4ilo/Wireless-Jukebox/Wireless Jukebox pcb/pcbV1.png

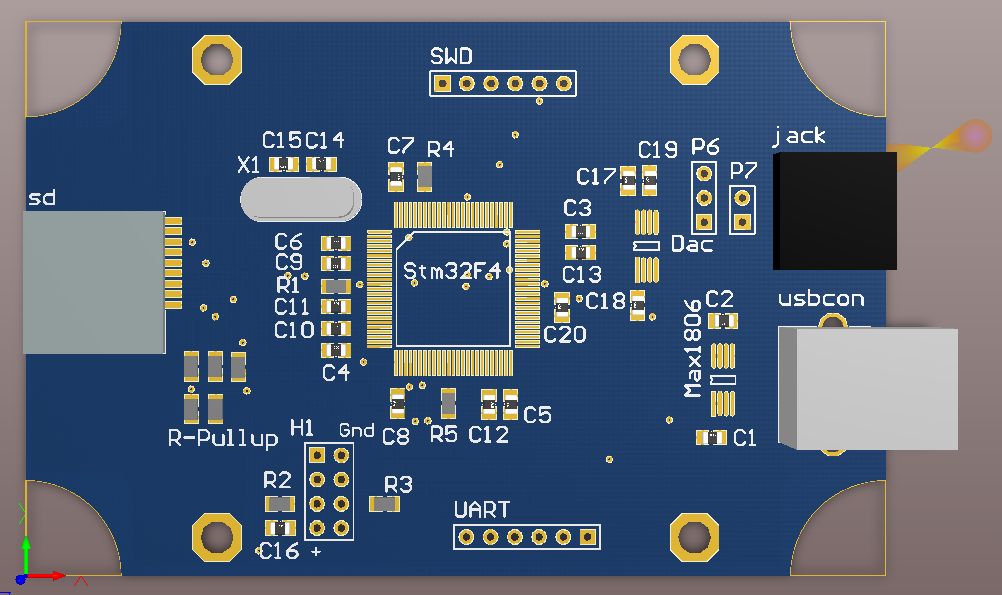
Wireless Jukebox pcb/pcbV1.png
