4ilo/Wireless-Jukebox/readme.md

# Wireless Jukebox

Ontwikkelen van een embedded systeem op basis van een cortex M4(stm42F411) dat muziek van een sd-kaart leest en deze afspeeld. De module wordt verbonden met een esp8266 wifi module waarop een webserver zal draaien. 
Gebruikers kunnen nu inloggen via wifi op de esp8266 en stemmen voor het volgende liedje. Als uitbreiding is het eventueel nog mogelijk om een wachtrij van liedjes te maken.
