4ilo/Wireless-Jukebox/Eindverslag/pdf/Bijlage 5.pdf

### Bijlage 5:

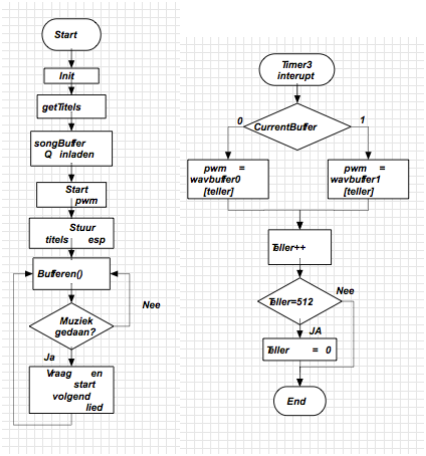
[picture p11: figure]

Fig1: Flowchart main

Fig2: Flowchart interrupt

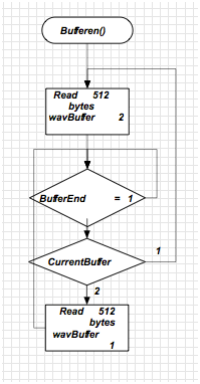
[picture p12: figure]

Fig3: Flowchart bufferen muziek
