4ilo/Wireless-Jukebox/Eindverslag/Bijlage/flowchart.pdf

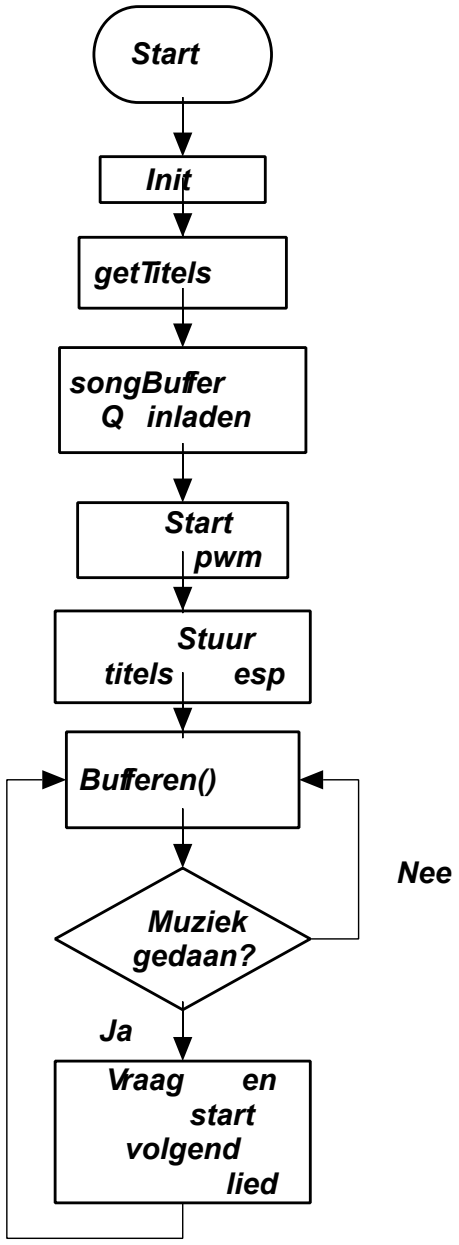
[picture p14: figure]
Start; Init; getTitels; songBuffer Q inladen; Start pwm; Stuur; titels; esp; Bufferen(); Muziek gedaan?; Vraag; start volgend lied; Nee
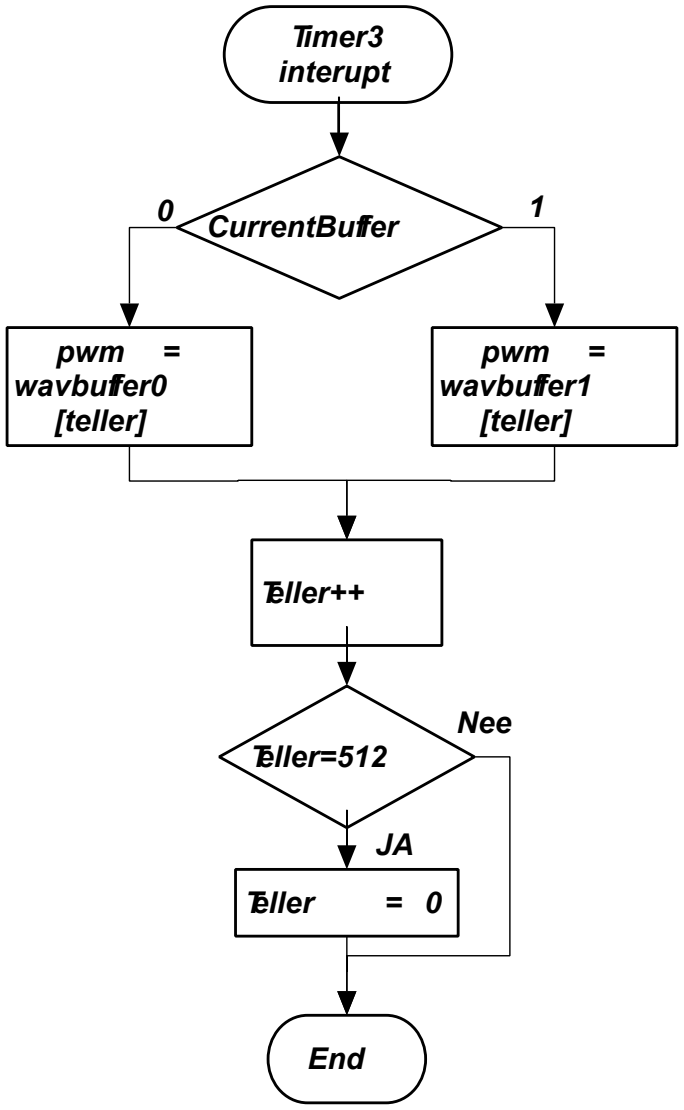
[picture p15: figure]
Timer3 interupt; CurrentBuffer; pwm = wavbuffer0 [teller]; pwm = wavbuffer1 [teller]; Teller++; Teller=512; Teller; End; Nee
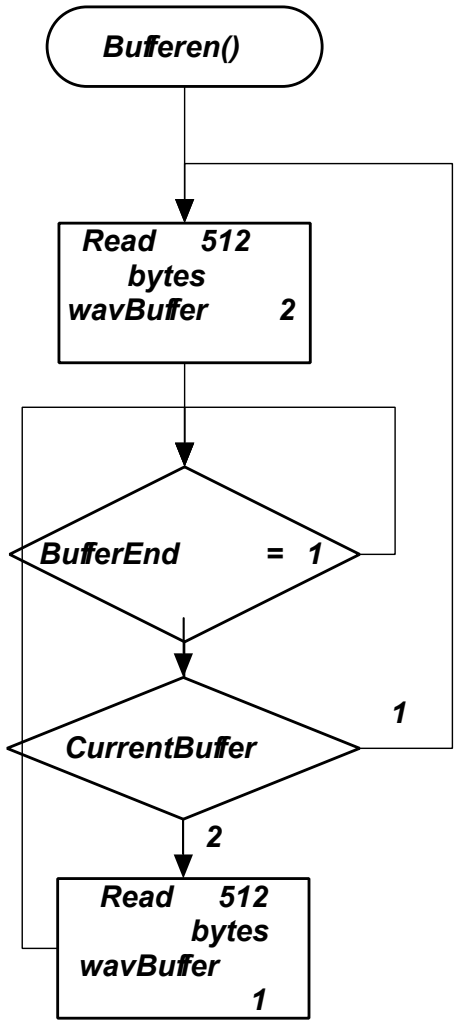
[picture p16: figure]
Bufferen(); Read; bytes wavBuffer; BufferEnd; CurrentBuffer
