4ilo/Wireless-Jukebox/Eindverslag/pdf/voorwoord.pdf

### Voorwoord

Ik ben Olivier Van den Eede.
olivier.vandeneede@student.thomasmore.be
Voor mijn opleiding Electronica-Ict in de 2de fase aan Thomas More De Nayer heb ik een project gemaakt, namelijk de Wireless-Jukebox.
De reden voor het maken van dit project is omdat ik graag wilde werken met een 32bit microcontroller, een SD-kaart en een wifi-module. Dit project beantwoord aan al deze criteria.

2
