4ilo/Wireless-Jukebox/cubeMX layout/LayoutV1.png

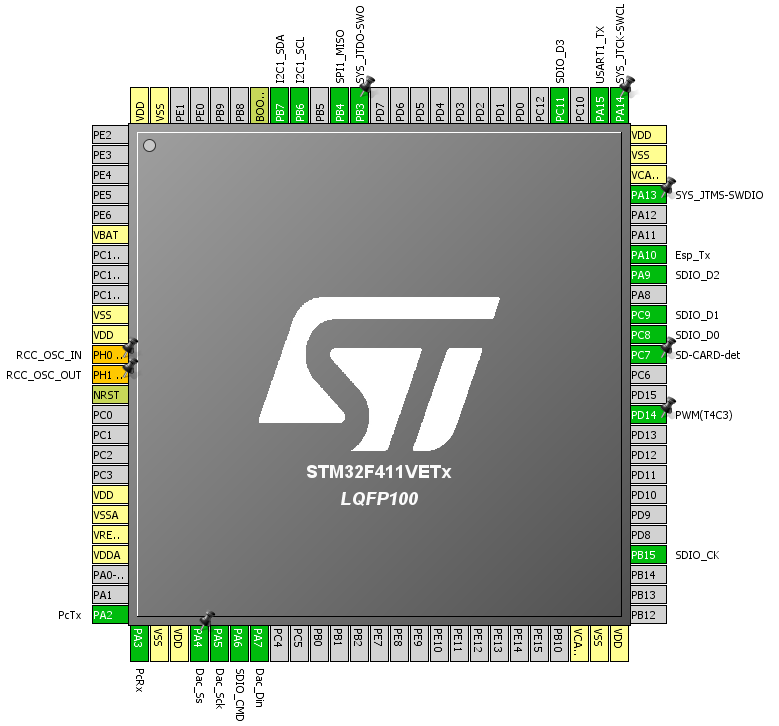
cubeMX layout/LayoutV1.png
