4ilo/Wireless-Jukebox/Eindverslag/foto's/blokschema.png

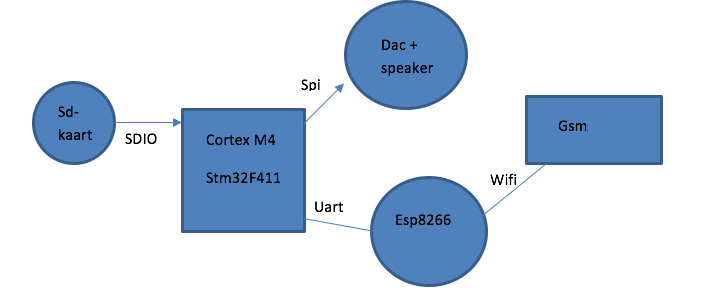
Eindverslag/foto's/blokschema.png
