4ilo/Wireless-Jukebox/Eindverslag/foto's/pcb.png

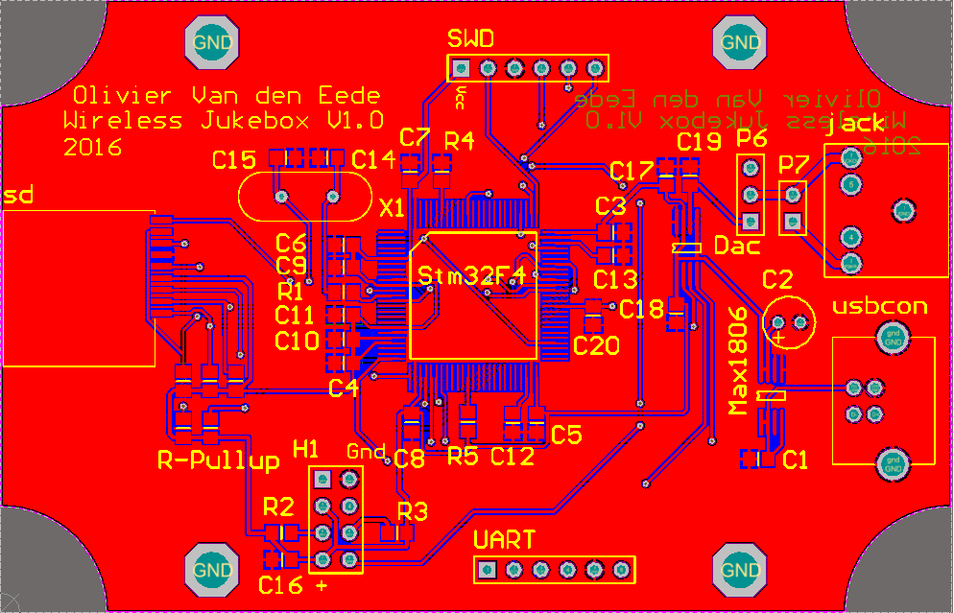
Eindverslag/foto's/pcb.png
