4ilo/Wireless-Jukebox/Eindverslag/foto's/schema.png

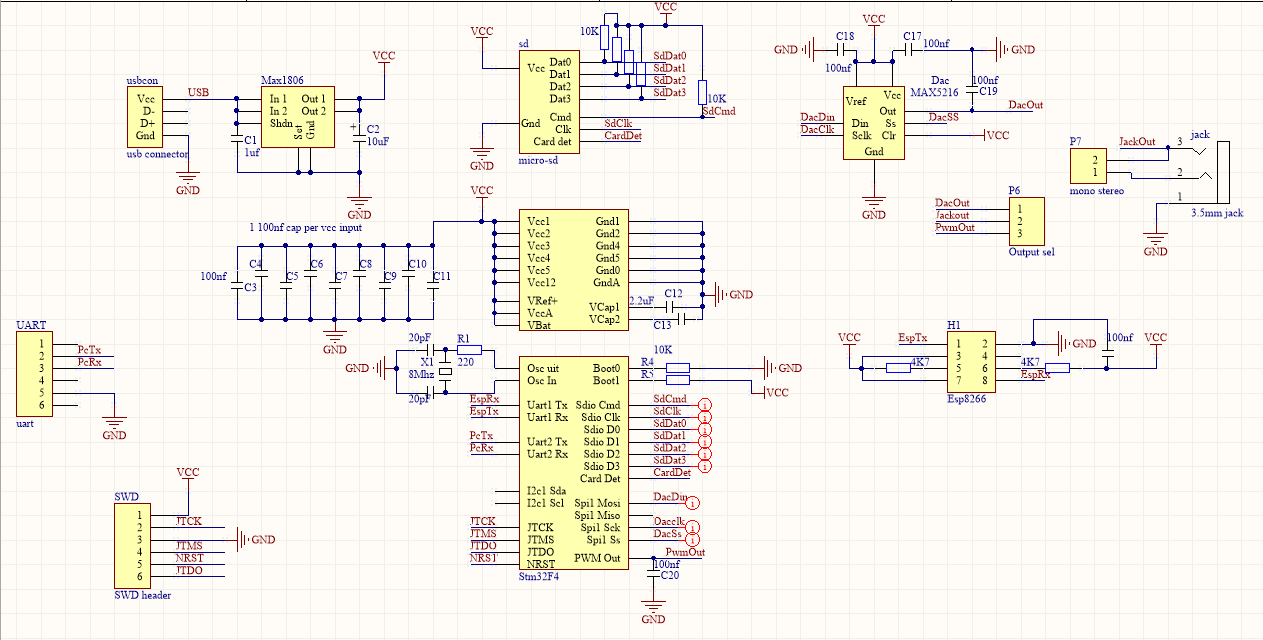
Eindverslag/foto's/schema.png
