4ilo/Wireless-Jukebox/Eindverslag/foto's/schema.pdf

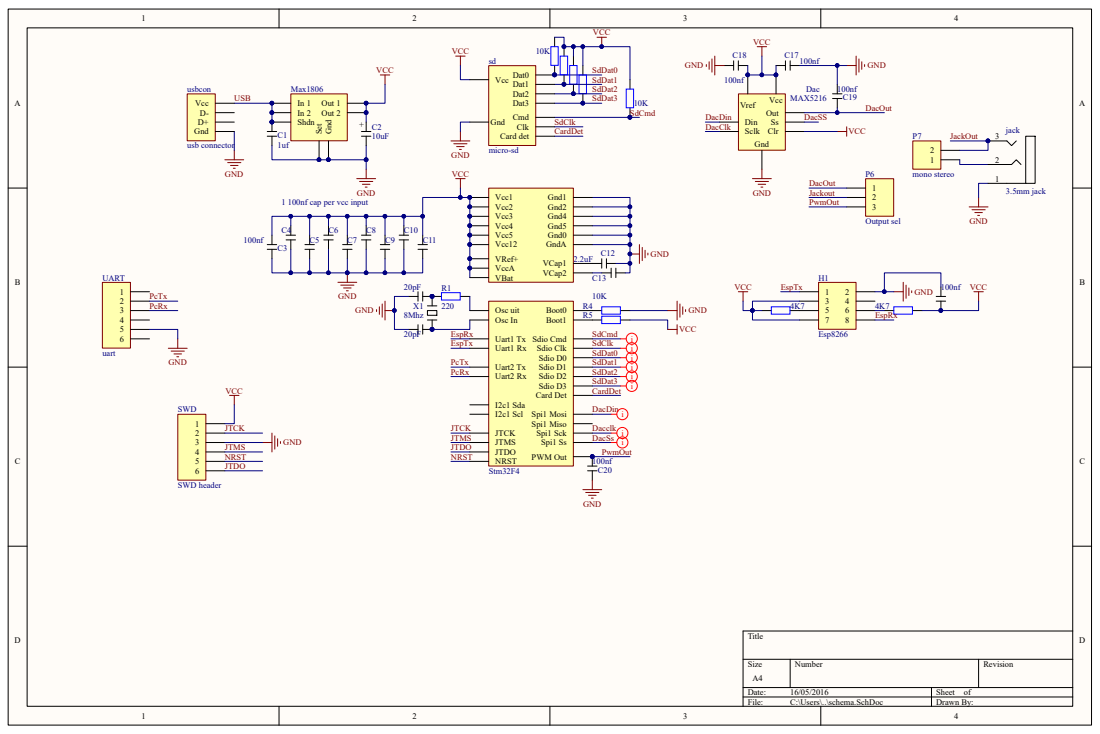
[picture p23: page 1]
