4ilo/Wireless-Jukebox/(list of files, drawings)

Other design files:
Wireless Jukebox pcb/componenten/comp.SchLib
Wireless Jukebox pcb/componenten/componenten.PcbLib
Wireless Jukebox pcb/PCB.PcbDoc
Wireless Jukebox pcb/schema.SchDoc
Wireless Jukebox pcb/Wireless Jukebox.PrjPcb
Wireless Jukebox/Wireless Jukebox.PrjPcb
