4ilo/Wireless-Jukebox/programma/Src/main.c

/**
  ******************************************************************************
  * File Name          : main.c
  * Description        : Main program body
  ******************************************************************************
  *
  * COPYRIGHT(c) 2016 STMicroelectronics
  *
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
  ******************************************************************************
  */
/* Includes ------------------------------------------------------------------*/
#include "stm32f4xx_hal.h"
#include "fatfs.h"

/* USER CODE BEGIN Includes */

#include <string.h>
#include <stdlib.h>
#include "wav.h"
#include "esp.h"

/* USER CODE END Includes */

I2C_HandleTypeDef hi2c1;

SD_HandleTypeDef hsd;
HAL_SD_CardInfoTypedef SDCardInfo;

SPI_HandleTypeDef hspi1;

TIM_HandleTypeDef htim3;
TIM_HandleTypeDef htim4;

UART_HandleTypeDef huart1;
UART_HandleTypeDef huart2;

/* USER CODE BEGIN PV */

// Deze variabelen zijn de buffers voor de wav file
volatile char wavBuffer0[512],wavBuffer1[512];
volatile uint8_t wavBufferSelect = 0;
volatile uint8_t bufferEnd,songEnd = 0;

// Var voor het fatfs filesystem
FATFS SDFatFs;

/* USER CODE END PV */

void SystemClock_Config(void);
static void MX_GPIO_Init(void);
static void MX_I2C1_Init(void);
static void MX_SDIO_SD_Init(void);
static void MX_SPI1_Init(void);
static void MX_TIM4_Init(void);
static void MX_USART2_UART_Init(void);
static void MX_TIM3_Init(void);
static void MX_USART1_UART_Init(void);

void HAL_TIM_MspPostInit(TIM_HandleTypeDef *htim);
                

/* USER CODE BEGIN PFP */

/* USER CODE END PFP */

/* USER CODE BEGIN 0 */

//
//  Deze interuptroutine wordt opgeroepen bij elke timer comp-match
//
void HAL_TIM_PeriodElapsedCallback(TIM_HandleTypeDef *htim)
{
  static uint16_t teller = 0;

  // We willen enkel de compare van timer3
  if(htim->Instance ==  TIM3)
  {
    if(wavBufferSelect == 0)  // Kijken uit welke buffer we moeten lezen
    {
      __HAL_TIM_SET_COMPARE(&htim4,TIM_CHANNEL_3, (wavBuffer0[teller] + 100));
    }
    else
    {
      __HAL_TIM_SET_COMPARE(&htim4,TIM_CHANNEL_3, (wavBuffer1[teller] + 100));
    }
    teller++;

    if(teller >= 512)
    {
      bufferEnd = 1;
      wavBufferSelect = ! wavBufferSelect;
      teller = 0;
    }
  }
}

/* USER CODE END 0 */

int main(void)
{

  /* MCU Configuration----------------------------------------------------------*/

  /* Reset of all peripherals, Initializes the Flash interface and the Systick. */
  HAL_Init();

  /* Configure the system clock */
  SystemClock_Config();

  /* Initialize all configured peripherals */
  MX_GPIO_Init();
  MX_I2C1_Init();
  MX_SDIO_SD_Init();
  MX_SPI1_Init();
  MX_TIM4_Init();
  MX_USART2_UART_Init();
  MX_TIM3_Init();
  MX_USART1_UART_Init();
  MX_FATFS_Init();

  /* USER CODE BEGIN 2 */

  uint8_t aantalNummers = 0;

  // De variabele waar de file inzit
  FIL MyFile;

  HAL_UART_Transmit(&huart2,"Wireless jukebox V1.0",21,10);

  // We halen alle titels op vanaf de sd-kaart en slagen deze op in een array
  char * titels[20];
  aantalNummers = getTitels(&MyFile,titels,20);

  // We sturen de eerste liedjes naar de esp
  uint8_t selectedSongs[4] = {0};
  randomNummers(selectedSongs,aantalNummers);

  // We gaan nu de eerste wav buffer vullen, hiervoor pakken we steeds nummer 0
  probeer(f_open(&MyFile,"0.wav",FA_READ),"openen file 0.wav");
  getData(&MyFile,wavBuffer0,512);
  getData(&MyFile,wavBuffer1,512);
  //f_close(&MyFile);

  // Timer3 en pwm output starten
  startPwm();

  // We zetten de eerste titels op de esp
  uint8_t teller;
  HAL_Delay(5000);    // We moeten wachten zodat de esp zeker opgestart is
  
  sendSongsToEsp(titels,selectedSongs);

  uint8_t volgendLiedId = 0;
  char buffer[100];
  char openSongString[6];

  /* USER CODE END 2 */

  /* Infinite loop */
  /* USER CODE BEGIN WHILE */
  while (1)
  {
  /* USER CODE END WHILE */

  /* USER CODE BEGIN 3 */

    if((songEnd == 1) && (bufferEnd == 1))  // als liedje gedaan is
    {
      // We stoppen de pwm
      stopPwm();    

      // We sluiten de file
      f_close(&MyFile);

      volgendLiedId = getBest() - 1;
      volgendLiedId = selectedSongs[volgendLiedId];    // Id van het volgend liedje ophalen
      sprintf(openSongString,"%d.wav",volgendLiedId);  // Zo staat het liedje op de schijf

      // We openen de nieuwe file
      probeer(f_open(&MyFile,openSongString,FA_READ),"open nieuw liedje");

      // Liedjes voor de volgende stemming kiezen
      randomNummers(selectedSongs,aantalNummers);
      sendSongsToEsp(titels,selectedSongs);

      // Alles terug in de beginpositie
      getData(&MyFile,wavBuffer0,512);
      wavBufferSelect = 0;
      bufferEnd = 0;
      songEnd = 0;
      startPwm();

    }
    
    if(bufferEnd == 1)
    {
      bufferEnd = 0;
      if(wavBufferSelect == 0)    // Kijken in welke buffer de interupt aan het lezen is
      {
        // Interupt leest in 0, wij schrijven in 1
        if(getData(&MyFile,wavBuffer1,512) == 1 ) songEnd = 1;

      }
      else
      {
        if(getData(&MyFile,wavBuffer0,512) == 1 ) songEnd = 1;
      }

    }
  }
  /* USER CODE END 3 */

}

/** System Clock Configuration
*/
void SystemClock_Config(void)
{

  RCC_OscInitTypeDef RCC_OscInitStruct;
  RCC_ClkInitTypeDef RCC_ClkInitStruct;

  __PWR_CLK_ENABLE();

  __HAL_PWR_VOLTAGESCALING_CONFIG(PWR_REGULATOR_VOLTAGE_SCALE1);

  RCC_OscInitStruct.OscillatorType = RCC_OSCILLATORTYPE_HSE;
  RCC_OscInitStruct.HSEState = RCC_HSE_ON;
  RCC_OscInitStruct.PLL.PLLState = RCC_PLL_ON;
  RCC_OscInitStruct.PLL.PLLSource = RCC_PLLSOURCE_HSE;
  RCC_OscInitStruct.PLL.PLLM = 4;
  RCC_OscInitStruct.PLL.PLLN = 192;
  RCC_OscInitStruct.PLL.PLLP = RCC_PLLP_DIV4;
  RCC_OscInitStruct.PLL.PLLQ = 8;
  HAL_RCC_OscConfig(&RCC_OscInitStruct);

  RCC_ClkInitStruct.ClockType = RCC_CLOCKTYPE_HCLK|RCC_CLOCKTYPE_SYSCLK
                              |RCC_CLOCKTYPE_PCLK1|RCC_CLOCKTYPE_PCLK2;
  RCC_ClkInitStruct.SYSCLKSource = RCC_SYSCLKSOURCE_PLLCLK;
  RCC_ClkInitStruct.AHBCLKDivider = RCC_SYSCLK_DIV1;
  RCC_ClkInitStruct.APB1CLKDivider = RCC_HCLK_DIV4;
  RCC_ClkInitStruct.APB2CLKDivider = RCC_HCLK_DIV2;
  HAL_RCC_ClockConfig(&RCC_ClkInitStruct, FLASH_LATENCY_3);

  HAL_SYSTICK_Config(HAL_RCC_GetHCLKFreq()/1000);

  HAL_SYSTICK_CLKSourceConfig(SYSTICK_CLKSOURCE_HCLK);

  /* SysTick_IRQn interrupt configuration */
  HAL_NVIC_SetPriority(SysTick_IRQn, 0, 0);
}



/* I2C1 init function */
void MX_I2C1_Init(void)
{

  hi2c1.Instance = I2C1;
  hi2c1.Init.ClockSpeed = 100000;
  hi2c1.Init.DutyCycle = I2C_DUTYCYCLE_2;
  hi2c1.Init.OwnAddress1 = 0;
  hi2c1.Init.AddressingMode = I2C_ADDRESSINGMODE_7BIT;
  hi2c1.Init.DualAddressMode = I2C_DUALADDRESS_DISABLED;
  hi2c1.Init.OwnAddress2 = 0;
  hi2c1.Init.GeneralCallMode = I2C_GENERALCALL_DISABLED;
  hi2c1.Init.NoStretchMode = I2C_NOSTRETCH_DISABLED;
  HAL_I2C_Init(&hi2c1);

}

/* SDIO init function */
void MX_SDIO_SD_Init(void)
{

  hsd.Instance = SDIO;
  hsd.Init.ClockEdge = SDIO_CLOCK_EDGE_RISING;
  hsd.Init.ClockBypass = SDIO_CLOCK_BYPASS_DISABLE;
  hsd.Init.ClockPowerSave = SDIO_CLOCK_POWER_SAVE_DISABLE;
  hsd.Init.BusWide = SDIO_BUS_WIDE_1B;
  hsd.Init.HardwareFlowControl = SDIO_HARDWARE_FLOW_CONTROL_DISABLE;
  hsd.Init.ClockDiv = 0;

}

/* SPI1 init function */
void MX_SPI1_Init(void)
{

  hspi1.Instance = SPI1;
  hspi1.Init.Mode = SPI_MODE_MASTER;
  hspi1.Init.Direction = SPI_DIRECTION_2LINES;
  hspi1.Init.DataSize = SPI_DATASIZE_8BIT;
  hspi1.Init.CLKPolarity = SPI_POLARITY_LOW;
  hspi1.Init.CLKPhase = SPI_PHASE_1EDGE;
  hspi1.Init.NSS = SPI_NSS_SOFT;
  hspi1.Init.BaudRatePrescaler = SPI_BAUDRATEPRESCALER_2;
  hspi1.Init.FirstBit = SPI_FIRSTBIT_MSB;
  hspi1.Init.TIMode = SPI_TIMODE_DISABLED;
  hspi1.Init.CRCCalculation = SPI_CRCCALCULATION_DISABLED;
  hspi1.Init.CRCPolynomial = 10;
  HAL_SPI_Init(&hspi1);

}

/* TIM3 init function */
void MX_TIM3_Init(void)
{

  TIM_ClockConfigTypeDef sClockSourceConfig;
  TIM_MasterConfigTypeDef sMasterConfig;

  htim3.Instance = TIM3;
  htim3.Init.Prescaler = 3;
  htim3.Init.CounterMode = TIM_COUNTERMODE_UP;
  htim3.Init.Period = 272;
  htim3.Init.ClockDivision = TIM_CLOCKDIVISION_DIV1;
  HAL_TIM_Base_Init(&htim3);

  sClockSourceConfig.ClockSource = TIM_CLOCKSOURCE_INTERNAL;
  HAL_TIM_ConfigClockSource(&htim3, &sClockSourceConfig);

  sMasterConfig.MasterOutputTrigger = TIM_TRGO_RESET;
  sMasterConfig.MasterSlaveMode = TIM_MASTERSLAVEMODE_DISABLE;
  HAL_TIMEx_MasterConfigSynchronization(&htim3, &sMasterConfig);

}

/* TIM4 init function */
void MX_TIM4_Init(void)
{

  TIM_ClockConfigTypeDef sClockSourceConfig;
  TIM_MasterConfigTypeDef sMasterConfig;
  TIM_OC_InitTypeDef sConfigOC;

  htim4.Instance = TIM4;
  htim4.Init.Prescaler = 0;
  htim4.Init.CounterMode = TIM_COUNTERMODE_UP;
  htim4.Init.Period = 456;
  htim4.Init.ClockDivision = TIM_CLOCKDIVISION_DIV1;
  HAL_TIM_Base_Init(&htim4);

  sClockSourceConfig.ClockSource = TIM_CLOCKSOURCE_INTERNAL;
  HAL_TIM_ConfigClockSource(&htim4, &sClockSourceConfig);

  HAL_TIM_PWM_Init(&htim4);

  sMasterConfig.MasterOutputTrigger = TIM_TRGO_RESET;
  sMasterConfig.MasterSlaveMode = TIM_MASTERSLAVEMODE_DISABLE;
  HAL_TIMEx_MasterConfigSynchronization(&htim4, &sMasterConfig);

  sConfigOC.OCMode = TIM_OCMODE_PWM1;
  sConfigOC.Pulse = 0;
  sConfigOC.OCPolarity = TIM_OCPOLARITY_HIGH;
  sConfigOC.OCFastMode = TIM_OCFAST_DISABLE;
  HAL_TIM_PWM_ConfigChannel(&htim4, &sConfigOC, TIM_CHANNEL_3);

  HAL_TIM_MspPostInit(&htim4);

}

/* USART1 init function */
void MX_USART1_UART_Init(void)
{

  huart1.Instance = USART1;
  huart1.Init.BaudRate = 9600;
  huart1.Init.WordLength = UART_WORDLENGTH_8B;
  huart1.Init.StopBits = UART_STOPBITS_1;
  huart1.Init.Parity = UART_PARITY_NONE;
  huart1.Init.Mode = UART_MODE_TX_RX;
  huart1.Init.HwFlowCtl = UART_HWCONTROL_NONE;
  huart1.Init.OverSampling = UART_OVERSAMPLING_16;
  HAL_UART_Init(&huart1);

}

/* USART2 init function */
void MX_USART2_UART_Init(void)
{

  huart2.Instance = USART2;
  huart2.Init.BaudRate = 115200;
  huart2.Init.WordLength = UART_WORDLENGTH_8B;
  huart2.Init.StopBits = UART_STOPBITS_1;
  huart2.Init.Parity = UART_PARITY_NONE;
  huart2.Init.Mode = UART_MODE_TX_RX;
  huart2.Init.HwFlowCtl = UART_HWCONTROL_NONE;
  huart2.Init.OverSampling = UART_OVERSAMPLING_16;
  HAL_UART_Init(&huart2);

}

/** Configure pins as 
        * Analog 
        * Input 
        * Output
        * EVENT_OUT
        * EXTI
*/
void MX_GPIO_Init(void)
{

  GPIO_InitTypeDef GPIO_InitStruct;

  /* GPIO Ports Clock Enable */
  __GPIOH_CLK_ENABLE();
  __GPIOA_CLK_ENABLE();
  __GPIOB_CLK_ENABLE();
  __GPIOD_CLK_ENABLE();
  __GPIOC_CLK_ENABLE();

  /*Configure GPIO pin Output Level */
  HAL_GPIO_WritePin(Dac_Ss_GPIO_Port, Dac_Ss_Pin, GPIO_PIN_RESET);

  /*Configure GPIO pin : Dac_Ss_Pin */
  GPIO_InitStruct.Pin = Dac_Ss_Pin;
  GPIO_InitStruct.Mode = GPIO_MODE_OUTPUT_PP;
  GPIO_InitStruct.Pull = GPIO_NOPULL;
  GPIO_InitStruct.Speed = GPIO_SPEED_LOW;
  HAL_GPIO_Init(Dac_Ss_GPIO_Port, &GPIO_InitStruct);

  /*Configure GPIO pin : SD_CARD_det_Pin */
  GPIO_InitStruct.Pin = SD_CARD_det_Pin;
  GPIO_InitStruct.Mode = GPIO_MODE_INPUT;
  GPIO_InitStruct.Pull = GPIO_NOPULL;
  HAL_GPIO_Init(SD_CARD_det_GPIO_Port, &GPIO_InitStruct);

}

#ifdef USE_FULL_ASSERT

/**
   * @brief Reports the name of the source file and the source line number
   * where the assert_param error has occurred.
   * @param file: pointer to the source file name
   * @param line: assert_param error line source number
   * @retval None
   */
void assert_failed(uint8_t* file, uint32_t line)
{
  /* USER CODE BEGIN 6 */
  /* User can add his own implementation to report the file name and line number,
    ex: printf("Wrong parameters value: file %s on line %d\r\n", file, line) */
  /* USER CODE END 6 */

}

#endif

/**
  * @}
  */ 

/**
  * @}
*/ 

/************************ (C) COPYRIGHT STMicroelectronics *****END OF FILE****/
