4ilo/Wireless-Jukebox/programma/Wireless jukebox prog.ioc

Mcu.UserName=STM32F411VETx
PA1.Signal=ADCx_IN1
PA10.GPIO_Label=Esp_Rx
PA10.Signal=USART1_RX
PA13.Signal=SYS_JTMS-SWDIO
PA14.Signal=SYS_JTCK-SWCLK
PA15.GPIO_Label=Esp_Tx
PA15.Signal=USART1_TX
PA2.GPIO_Label=PcTx
PA2.Signal=USART2_TX
PA3.GPIO_Label=PcRx
PA3.Signal=USART2_RX
PA4.GPIO_Label=Dac_Ss
PA4.Signal=GPIO_Output
PA5.GPIO_Label=Dac_Sck
PA5.Signal=SPI1_SCK
PA6.Signal=SDIO_CMD
PA7.GPIO_Label=Dac_Din
PA7.Signal=SPI1_MOSI
PA9.Signal=SDIO_D2
PB15.Signal=SDIO_CK
PB3.Signal=SYS_JTDO-SWO
PB4.Signal=SPI1_MISO
PB6.Signal=I2C1_SCL
PB7.Signal=I2C1_SDA
PC11.Signal=SDIO_D3
PC7.GPIO_Label=SD-CARD-det
PC7.Signal=GPIO_Input
PC8.Signal=SDIO_D0
PC9.Signal=SDIO_D1
PD14.GPIO_Label=PWM(T4C3)
PD14.Signal=S_TIM4_CH3
