4ilo/Wireless-Jukebox/(commit log)

2016-02-24 stm32f411 component getekend
    [Wireless Jukebox.PrjPcb, comp.SchLib, componenten.PcbLib, schema.SchDoc]
2016-02-25 Verdergewerkt schema
    getekend: usb-con, Vregelaar
    aangesloten: uC,voeding en esp header
    [comp.SchLib, componenten.PcbLib, schema.SchDoc]
2016-02-25 added boot1 pin
    [comp.SchLib, schema.SchDoc]
2016-02-27 dac en bootmode select toegevoegd
    [comp.SchLib, schema.SchDoc]
2016-02-27 programming header toegevoegd
    [comp.SchLib, schema.SchDoc]
2016-02-29 sd-interface toegevoegd
    [Wireless Jukebox.PrjPcb, comp.SchLib, componenten.PcbLib, schema.SchDoc]
2016-03-01 3.5mm jack toegevoegd + board layout defined
    [PCB.PcbDoc, Wireless Jukebox.PrjPcb, comp.SchLib, componenten.PcbLib, schema.SchDoc]
2016-03-02 verder tekenen pcb
    [PCB.PcbDoc, Wireless Jukebox.PrjPcb, comp.SchLib, componenten.PcbLib, schema.SchDoc]
2016-03-03 timer test
2016-03-05 deel van pcb geroute
    [PCB.PcbDoc, schema.SchDoc]
2016-03-05 ok
    opened altium
    [PCB.PcbDoc, componenten.PcbLib, schema.SchDoc]
2016-03-05 added ground plane
    [PCB.PcbDoc]
2016-03-05 fixed sd-silkscreen
    [PCB.PcbDoc, componenten.PcbLib, schema.SchDoc]
2016-03-05 testprogramme met timer
2016-03-05 pwm getest
2016-03-06 alle comp behalde stm-pinout gevalideerd
    [PCB.PcbDoc, comp.SchLib, schema.SchDoc]
2016-03-06 ckecked stm32 pinout en layout
    [PCB.PcbDoc, schema.SchDoc]
2016-03-06 fixed ground lane
    [PCB.PcbDoc]
2016-03-06 fixed bugs+ keep-out layer toegevoegd
    [PCB.PcbDoc, Wireless Jukebox.PrjPcb, componenten.PcbLib, schema.SchDoc]
2016-03-07 generated gerbers
    [PCB.DRL, PCB.GBL, PCB.GBO, PCB.GBS, PCB.GKO, PCB.GM1, PCB.GTL, PCB.GTO]
2016-03-08 c2 is nu elco,thrue hole
    [PCB.PcbDoc, Wireless Jukebox.PrjPcb, comp.SchLib, componenten.PcbLib, schema.SchDoc]
2016-03-08 in main terug naar 1bit-wide bus, mss bugfix
    [main.c]
2016-03-09 generated final gerbers + drc-ckeck
    [PCB.PcbDoc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]
2016-03-22 bugfixes in lua script
    [init.lua]
2016-03-24 begonnen aan stm programma voor esp->uart
2016-03-25 stm functies voor communicatie met de esp zijn klaar
2016-03-25 turned of echo op uart esp
2016-04-10 begonnen aan het eindverslag
2016-04-14 begonnen aan pwm music programma
2016-04-19 muziek kan afgespeed worden via pwm
2016-04-20 samplefrequentie van muziek files veranderd
2016-04-26 pwm beschreven in verslag
2016-04-28 testprogramma voor eigen pcb
2016-04-28 pwm output geimplementeerd
2016-04-29 sd-kaart werkt op pcb
2016-04-30 functie geschreven die alle titels van de sd-kaart leest
2016-05-02 project gemigreerd naar eclipse
    [wireless-jukebox.cfg]
2016-05-03 er kan gestemd worden op liedjes die afgespeeld worden
2016-05-10 update verslag + flowchart
2016-05-16 added foto's van pcb + schema
